SVashi/491-Project/KiCad/batteryless_gaming_device/batteryless_gaming_device.kicad_pcb

## KiCad design KiCad/batteryless_gaming_device/batteryless_gaming_device.kicad_pcb (2021-11-18)

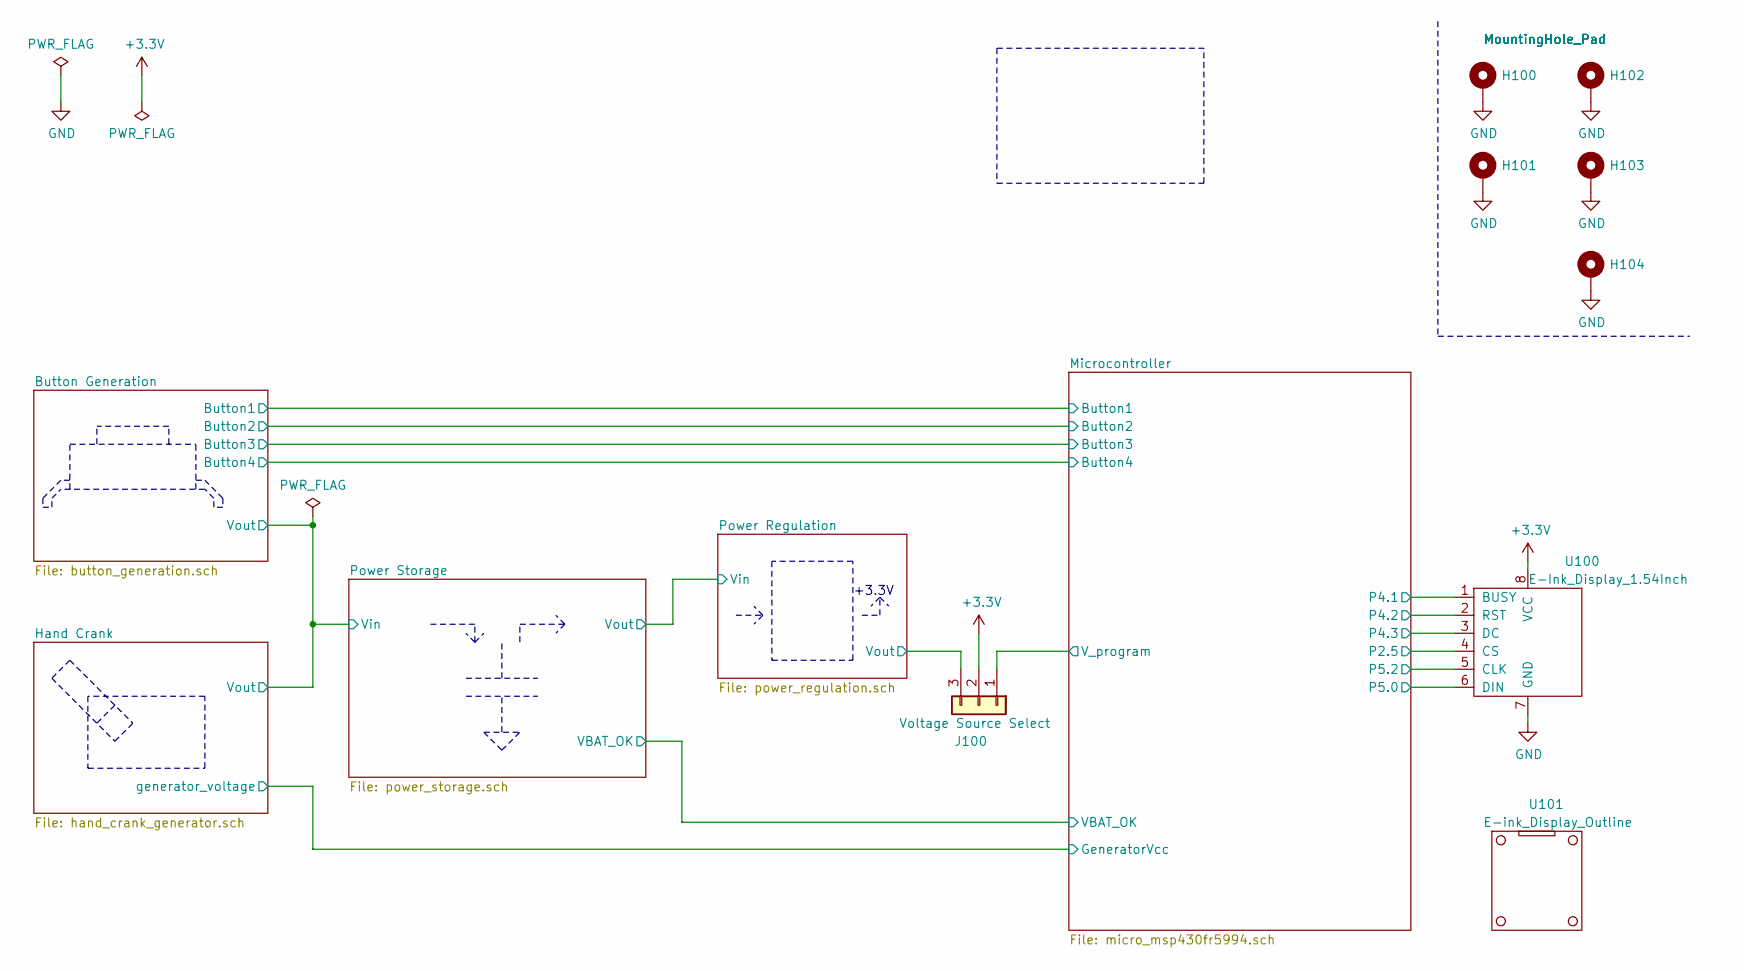
[picture p1: schematic batteryless_gaming_device.sch, Battery Free Gaming Device]

Parts:
H100, H101, H102, H103, H104: MountingHole_Pad; MountingHole_3.2mm_M3_DIN965_Pad
J100: Voltage Source Select; PinHeader_1x03_P2.54mm_Vertical
U100: E-Ink_Display_1.54Inch; PinHeader_1x08_P2.54mm_Horizontal
U101: E-ink_Display_Outline; E-Ink_Display_1.54Inch

Connections:
+3V3: J100.2, U100.8 (VCC); also elsewhere on the board
/Microcontroller/P2.5: U100.4 (CS); also elsewhere on the board
/Microcontroller/P4.1: U100.1 (BUSY); also elsewhere on the board
/Microcontroller/P4.2: U100.2 (RST); also elsewhere on the board
/Microcontroller/P4.3: U100.3 (DC); also elsewhere on the board
/Microcontroller/P5.0: U100.6 (DIN); also elsewhere on the board
/Microcontroller/P5.2: U100.5 (CLK); also elsewhere on the board
/Microcontroller/V_program: J100.1; also elsewhere on the board
/Power Regulation/Vout: J100.3; also elsewhere on the board
GND: H100.1, H101.1, H102.1, H103.1, H104.1, U100.7 (GND); also elsewhere on the board

Notes on the sheet:
+3.3V

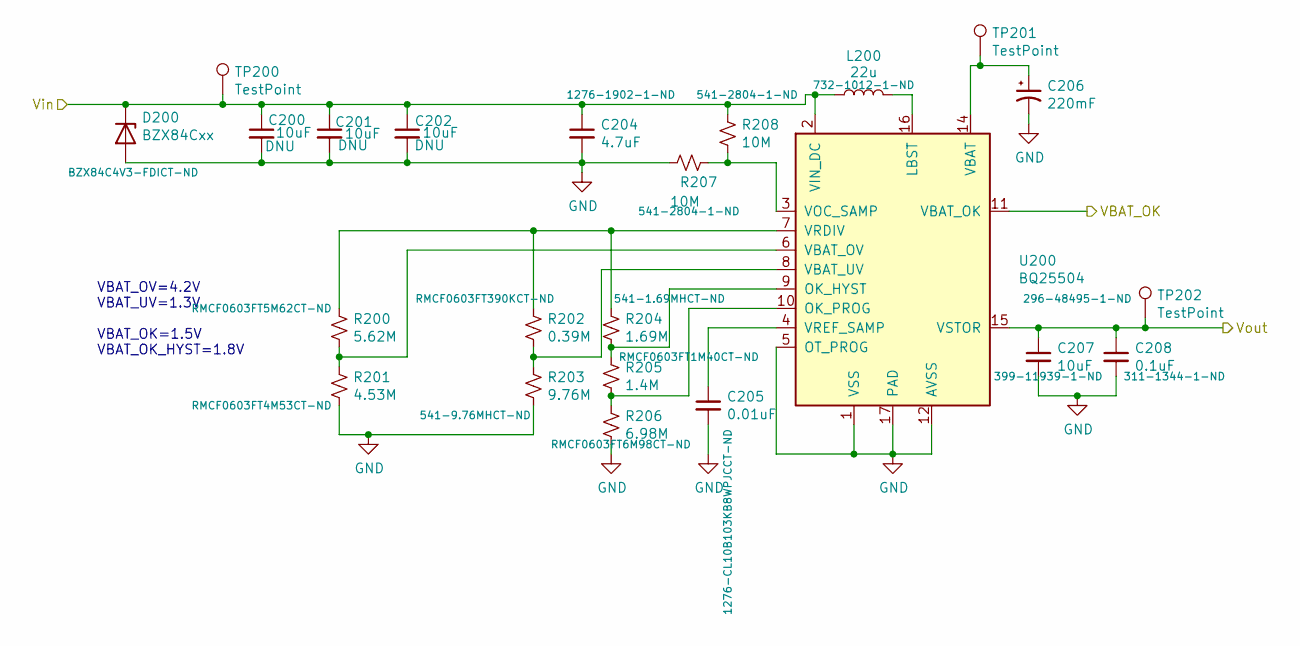
[picture p2: schematic power_storage.sch]

Parts:
C200, C201, C202: 10uF; C_0805_2012Metric_Pad1.18x1.45mm_HandSolder; Digikey PN DNU
C204: 4.7uF; C_0603_1608Metric_Pad1.08x0.95mm_HandSolder; Digikey PN 1276-1902-1-ND
C205: 0.01uF; C_0603_1608Metric_Pad1.08x0.95mm_HandSolder; Digikey PN 1276-CL10B103KB8WPJCCT-ND
C206: 220mF; CP_Radial_D14.0mm_P5.00mm
C207: 10uF; C_0805_2012Metric_Pad1.18x1.45mm_HandSolder; Digikey PN 399-11939-1-ND
C208: 0.1uF; C_0603_1608Metric_Pad1.08x0.95mm_HandSolder; Digikey PN 311-1344-1-ND
D200: BZX84Cxx; D_SOT-23_ANK_HandSoldering; Digikey PN BZX84C4V3-FDICT-ND
L200: 22u; L_Wuerth-3816_6.3x6.3mm; Digikey PN 732-1012-1-ND
R200: 5.62M; R_0603_1608Metric_Pad0.98x0.95mm_HandSolder; Digikey PN RMCF0603FT5M62CT-ND
R201: 4.53M; R_0603_1608Metric_Pad0.98x0.95mm_HandSolder; Digikey PN RMCF0603FT4M53CT-ND
R202: 0.39M; R_0603_1608Metric_Pad0.98x0.95mm_HandSolder; Digikey PN RMCF0603FT390KCT-ND
R203: 9.76M; R_0603_1608Metric_Pad0.98x0.95mm_HandSolder; Digikey PN 541-9.76MHCT-ND
R204: 1.69M; R_0603_1608Metric_Pad0.98x0.95mm_HandSolder; Digikey PN 541-1.69MHCT-ND
R205: 1.4M; R_0603_1608Metric_Pad0.98x0.95mm_HandSolder; Digikey PN RMCF0603FT1M40CT-ND
R206: 6.98M; R_0603_1608Metric_Pad0.98x0.95mm_HandSolder; Digikey PN RMCF0603FT6M98CT-ND
R207, R208: 10M; R_0603_1608Metric_Pad0.98x0.95mm_HandSolder; Digikey PN 541-2804-1-ND
TP200, TP201, TP202: TestPoint; TestPoint_Pad_D2.0mm
U200: BQ25504; VQFN-16-1EP_3x3mm_P0.5mm_EP1.8x1.8mm; Digikey PN 296-48495-1-ND

Connections:
/Microcontroller/VBAT_OK: U200.11 (VBAT_OK); also elsewhere on the board
/Power Regulation/Vin: C207.1, C208.1, TP202.1, U200.15 (VSTOR); also elsewhere on the board
/Power Storage/Vin: C200.1, C201.1, C202.1, C204.1, D200.1 (K), L200.1, R208.1, TP200.1, U200.2 (VIN_DC); also elsewhere on the board
GND: C200.2, C201.2, C202.2, C204.2, C205.2, C206.2, C207.2, C208.2, D200.2 (A), R201.2, R203.2, R206.2, R207.2, U200.1 (VSS), U200.5 (OT_PROG), U200.12 (AVSS), U200.13 (VSS), U200.17 (PAD); also elsewhere on the board
unnamed: C205.1, U200.4 (VREF_SAMP)
unnamed: C206.1, TP201.1, U200.14 (VBAT)
unnamed: L200.2, U200.16 (LBST)
unnamed: R200.1, R202.1, R204.1, U200.7 (VRDIV)
unnamed: R200.2, R201.1, U200.6 (VBAT_OV)
unnamed: R202.2, R203.1, U200.8 (VBAT_UV)
unnamed: R204.2, R205.1, U200.9 (OK_HYST)
unnamed: R205.2, R206.1, U200.10 (OK_PROG)
unnamed: R207.1, R208.2, U200.3 (VOC_SAMP)

Notes on the sheet:
VBAT_OV=4.2V VBAT_UV=1.3V VBAT_OK=1.5V VBAT_OK_HYST=1.8V

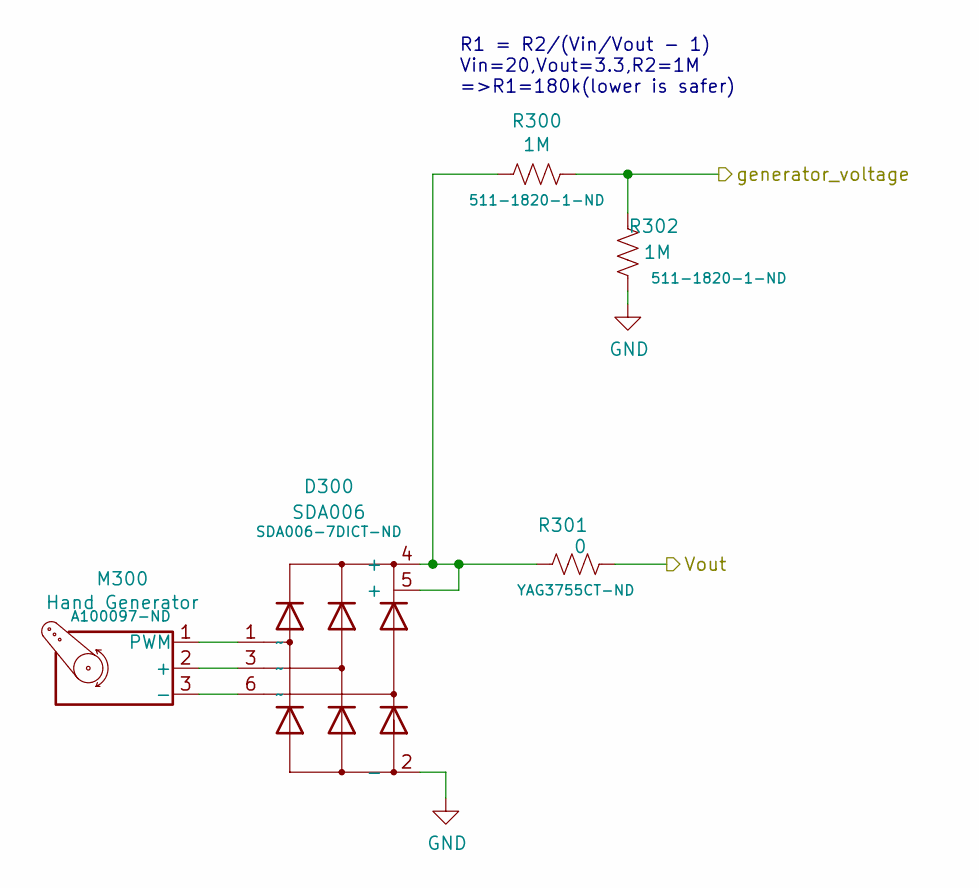
[picture p3: schematic hand_crank_generator.sch]

Parts:
D300: SDA006; SOT-363_SC-70-6_Handsoldering; Digikey PN SDA006-7DICT-ND
M300: Hand Generator; PinHeader_1x03_P2.00mm_Vertical; Digikey PN A100097-ND
R300, R302: 1M; R_0603_1608Metric_Pad0.98x0.95mm_HandSolder; Digikey PN 511-1820-1-ND
R301: 0; R_0805_2012Metric_Pad1.20x1.40mm_HandSolder; Digikey PN YAG3755CT-ND

Connections:
/Microcontroller/GeneratorVcc: R300.1, R302.2; also elsewhere on the board
/Power Storage/Vin: R301.2; also elsewhere on the board
GND: D300.2 (-), R302.1; also elsewhere on the board
unnamed: D300.1 (~~), M300.1 (PWM)
unnamed: D300.3 (~~), M300.2 (+)
unnamed: D300.4 (+), D300.5 (+), R300.2, R301.1
unnamed: D300.6 (~~), M300.3 (-)

Notes on the sheet:
R1 = R2/(Vin/Vout - 1) Vin=20,Vout=3.3,R2=1M =>R1=180k(lower is safer)

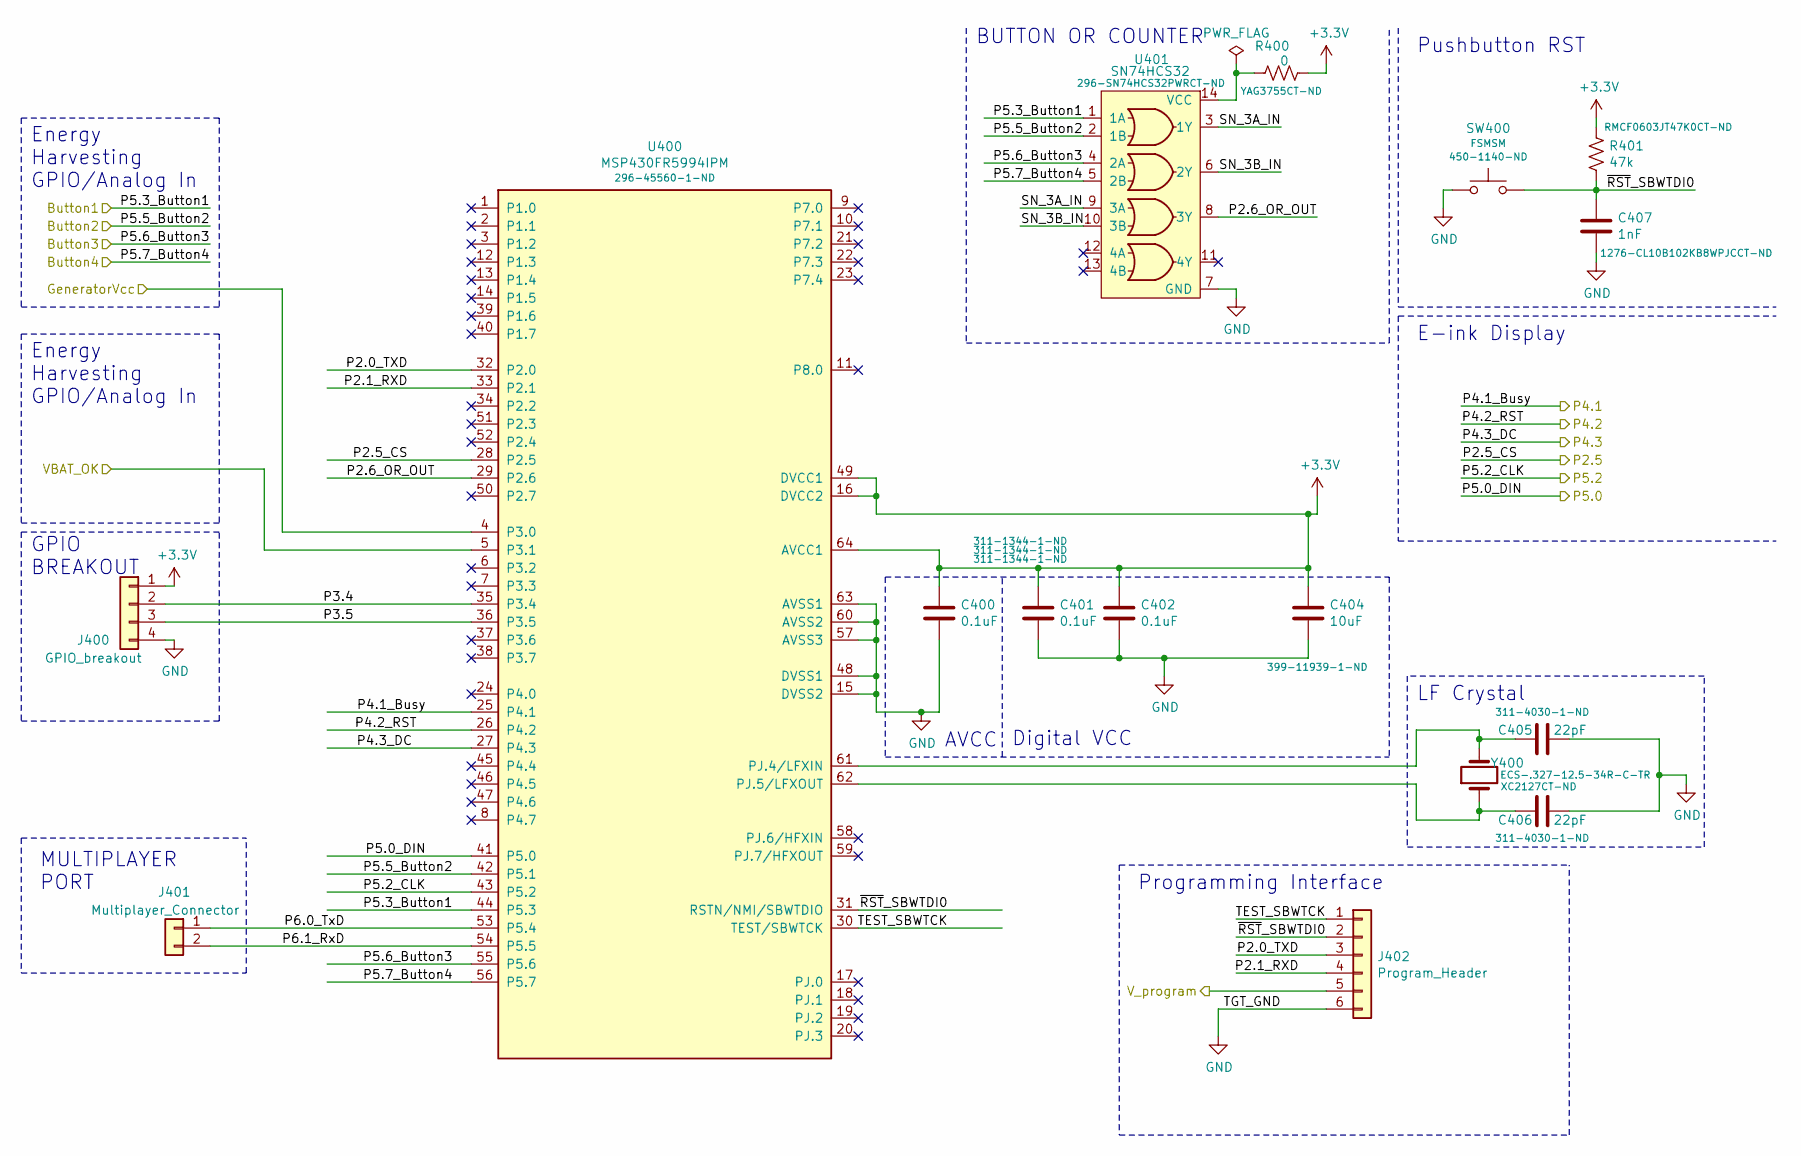
[picture p4: schematic micro_msp430fr5994.sch]

Parts:
C400, C401, C402: 0.1uF; C_0603_1608Metric_Pad1.08x0.95mm_HandSolder; Digikey PN 311-1344-1-ND
C404: 10uF; C_0805_2012Metric_Pad1.18x1.45mm_HandSolder; Digikey PN 399-11939-1-ND
C405, C406: 22pF; C_0603_1608Metric_Pad1.08x0.95mm_HandSolder; Digikey PN 311-4030-1-ND
C407: 1nF; C_0603_1608Metric_Pad1.08x0.95mm_HandSolder; Digikey PN 1276-CL10B102KB8WPJCCT-ND
J400: GPIO_breakout; PinHeader_1x04_P2.54mm_Vertical
J401: Multiplayer_Connector; PinHeader_1x02_P2.54mm_Horizontal
J402: Program_Header; PinHeader_1x06_P2.54mm_Vertical
R400: 0; R_0805_2012Metric_Pad1.20x1.40mm_HandSolder; Digikey PN YAG3755CT-ND
R401: 47k; R_0603_1608Metric_Pad0.98x0.95mm_HandSolder; Digikey PN RMCF0603JT47K0CT-ND
SW400: FSMSM; SW_SPST_FSMSM; Digikey PN 450-1140-ND
U400: MSP430FR5994IPM; LQFP-64_10x10mm_P0.5mm; Digikey PN 296-45560-1-ND
U401: SN74HCS32; TSSOP-14_4.4x5mm_P0.65mm; Digikey PN 296-SN74HCS32PWRCT-ND
Y400: ECS-.327-12.5-34R-C-TR; Crystal_SMD_3215-2Pin_3.2x1.5mm; Digikey PN XC2127CT-ND

Connections:
+3V3: C400.1, C401.1, C402.1, C404.1, J400.1, R400.2, R401.1, U400.16 (DVCC2), U400.49 (DVCC1), U400.64 (AVCC1); also elsewhere on the board
/Button Generation/Button1: U400.44 (P5.3), U401.1 (1A); also elsewhere on the board
/Button Generation/Button2: U400.42 (P5.1), U401.2 (1B); also elsewhere on the board
/Button Generation/Button3: U400.55 (P5.6), U401.4 (2A); also elsewhere on the board
/Button Generation/Button4: U400.56 (P5.7), U401.5 (2B); also elsewhere on the board
/Microcontroller/GeneratorVcc: U400.4 (P3.0); also elsewhere on the board
/Microcontroller/P2.0_TXD: J402.3, U400.32 (P2.0)
/Microcontroller/P2.1_RXD: J402.4, U400.33 (P2.1)
/Microcontroller/P2.5: U400.28 (P2.5); also elsewhere on the board
/Microcontroller/P2.6_OR_OUT: U400.29 (P2.6), U401.8 (3Y)
/Microcontroller/P3.4: J400.2, U400.35 (P3.4)
/Microcontroller/P3.5: J400.3, U400.36 (P3.5)
/Microcontroller/P4.1: U400.25 (P4.1); also elsewhere on the board
/Microcontroller/P4.2: U400.26 (P4.2); also elsewhere on the board
/Microcontroller/P4.3: U400.27 (P4.3); also elsewhere on the board
/Microcontroller/P5.0: U400.41 (P5.0); also elsewhere on the board
/Microcontroller/P5.2: U400.43 (P5.2); also elsewhere on the board
/Microcontroller/P6.0_TxD: J401.1, U400.53 (P5.4)
/Microcontroller/P6.1_RxD: J401.2, U400.54 (P5.5)
/Microcontroller/SN_3A_IN: U401.3 (1Y), U401.9 (3A)
/Microcontroller/SN_3B_IN: U401.6 (2Y), U401.10 (3B)
/Microcontroller/TEST_SBWTCK: J402.1, U400.30 (TEST/SBWTCK)
/Microcontroller/VBAT_OK: U400.5 (P3.1); also elsewhere on the board
/Microcontroller/V_program: J402.5; also elsewhere on the board
/Microcontroller/~RST~_SBWTDI0: C407.1, J402.2, R401.2, SW400.2, U400.31 (RSTN/NMI/SBWTDIO)
GND: C400.2, C401.2, C402.2, C404.2, C405.2, C406.2, C407.2, J400.4, J402.6, SW400.1, U400.15 (DVSS2), U400.48 (DVSS1), U400.57 (AVSS3), U400.60 (AVSS2), U400.63 (AVSS1), U401.7 (GND); also elsewhere on the board
unnamed: C405.1, U400.61 (PJ.4/LFXIN), Y400.2
unnamed: C406.1, U400.62 (PJ.5/LFXOUT), Y400.1
unnamed: R400.1, U401.14 (VCC)

Notes on the sheet:
Digital VCC
AVCC
LF Crystal
Pushbutton RST
Programming Interface
Energy Harvesting GPIO/Analog In
E-ink Display
BUTTON OR COUNTER
MULTIPLAYER PORT
GPIO BREAKOUT

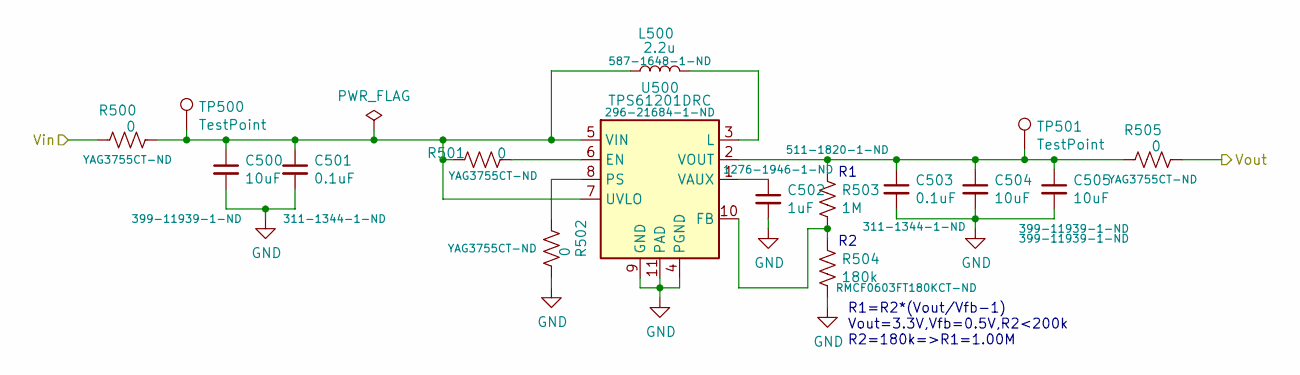
[picture p5: schematic power_regulation.sch]

Parts:
C500, C504, C505: 10uF; C_0805_2012Metric_Pad1.18x1.45mm_HandSolder; Digikey PN 399-11939-1-ND
C501, C503: 0.1uF; C_0603_1608Metric_Pad1.08x0.95mm_HandSolder; Digikey PN 311-1344-1-ND
C502: 1uF; C_0603_1608Metric_Pad1.08x0.95mm_HandSolder; Digikey PN 1276-1946-1-ND
L500: 2.2u; L_Taiyo-Yuden_NR-30xx_HandSoldering; Digikey PN 587-1648-1-ND
R500, R501, R502, R505: 0; R_0805_2012Metric_Pad1.20x1.40mm_HandSolder; Digikey PN YAG3755CT-ND
R503: 1M; R_0603_1608Metric_Pad0.98x0.95mm_HandSolder; Digikey PN 511-1820-1-ND
R504: 180k; R_0603_1608Metric_Pad0.98x0.95mm_HandSolder; Digikey PN RMCF0603FT180KCT-ND
TP500, TP501: TestPoint; TestPoint_Pad_D2.0mm
U500: TPS61201DRC; Texas_S-PVSON-N10_ThermalVias; Digikey PN 296-21684-1-ND

Connections:
/Power Regulation/Vin: R500.1; also elsewhere on the board
/Power Regulation/Vout: R505.2; also elsewhere on the board
GND: C500.2, C501.2, C502.2, C503.2, C504.2, C505.2, R502.2, R504.2, U500.4 (PGND), U500.9 (GND), U500.11 (PAD); also elsewhere on the board
unnamed: C500.1, C501.1, L500.1, R500.2, R501.1, TP500.1, U500.5 (VIN), U500.7 (UVLO)
unnamed: C502.1, U500.1 (VAUX)
unnamed: C503.1, C504.1, C505.1, R503.1, R505.1, TP501.1, U500.2 (VOUT)
unnamed: L500.2, U500.3 (L)
unnamed: R501.2, U500.6 (EN)
unnamed: R502.1, U500.8 (PS)
unnamed: R503.2, R504.1, U500.10 (FB)

Notes on the sheet:
R1=R2*(Vout/Vfb-1) Vout=3.3V,Vfb=0.5V,R2<200k R2=180k=>R1=1.00M

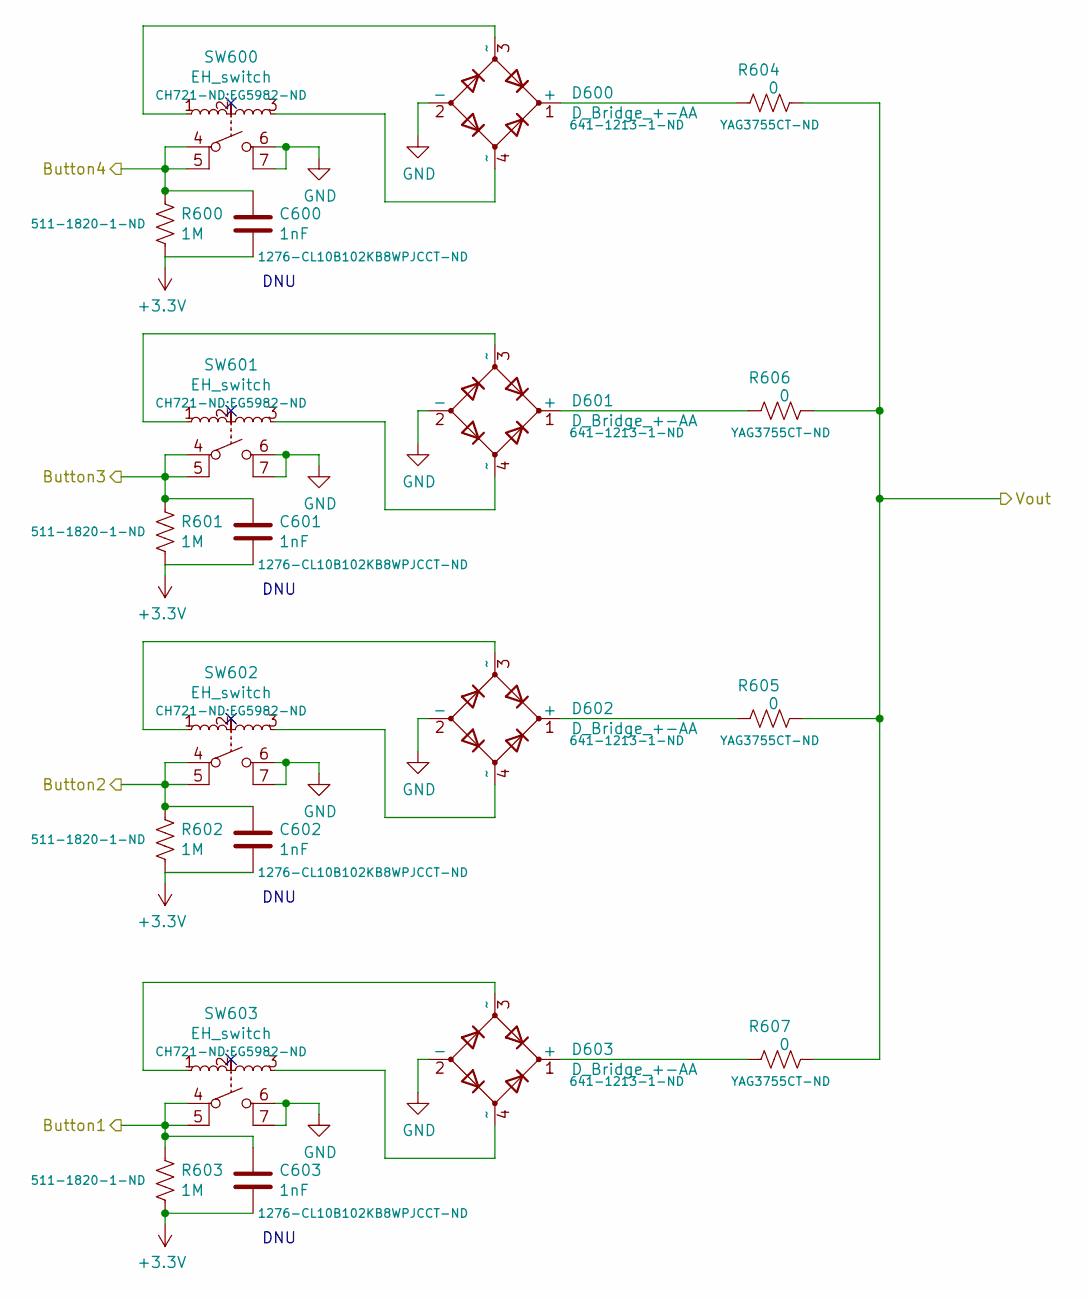
[picture p6: schematic button_generation.sch]

Parts:
C600, C601, C602, C603: 1nF; C_0603_1608Metric_Pad1.08x0.95mm_HandSolder; Digikey PN 1276-CL10B102KB8WPJCCT-ND
D600, D601, D602, D603: D_Bridge_+-AA; TO-269AA; Digikey PN 641-1213-1-ND
R600, R601, R602, R603: 1M; R_0603_1608Metric_Pad0.98x0.95mm_HandSolder; Digikey PN 511-1820-1-ND
R604, R605, R606, R607: 0; R_0805_2012Metric_Pad1.20x1.40mm_HandSolder; Digikey PN YAG3755CT-ND
SW600, SW601, SW602, SW603: EH_switch; EH_switch_v2; Digikey PN CH721-ND;EG5982-ND

Connections:
+3V3: C600.2, C601.2, C602.2, C603.2, R600.2, R601.2, R602.2, R603.2; also elsewhere on the board
/Button Generation/Button1: C603.1, R603.1, SW603.4 (1), SW603.5 (2); also elsewhere on the board
/Button Generation/Button2: C602.1, R602.1, SW602.4 (1), SW602.5 (2); also elsewhere on the board
/Button Generation/Button3: C601.1, R601.1, SW601.4 (1), SW601.5 (2); also elsewhere on the board
/Button Generation/Button4: C600.1, R600.1, SW600.4 (1), SW600.5 (2); also elsewhere on the board
/Power Storage/Vin: R604.2, R605.2, R606.2, R607.2; also elsewhere on the board
GND: D600.2 (-), D601.2 (-), D602.2 (-), D603.2 (-), SW600.6 (A), SW600.7 (K), SW601.6 (A), SW601.7 (K), SW602.6 (A), SW602.7 (K), SW603.6 (A), SW603.7 (K); also elsewhere on the board
unnamed: D600.1 (+), R604.1
unnamed: D600.3 (~~), SW600.1
unnamed: D600.4 (~~), SW600.3
unnamed: D601.1 (+), R606.1
unnamed: D601.3 (~~), SW601.1
unnamed: D601.4 (~~), SW601.3
unnamed: D602.1 (+), R605.1
unnamed: D602.3 (~~), SW602.1
unnamed: D602.4 (~~), SW602.3
unnamed: D603.1 (+), R607.1
unnamed: D603.3 (~~), SW603.1
unnamed: D603.4 (~~), SW603.3

Notes on the sheet:
DNU

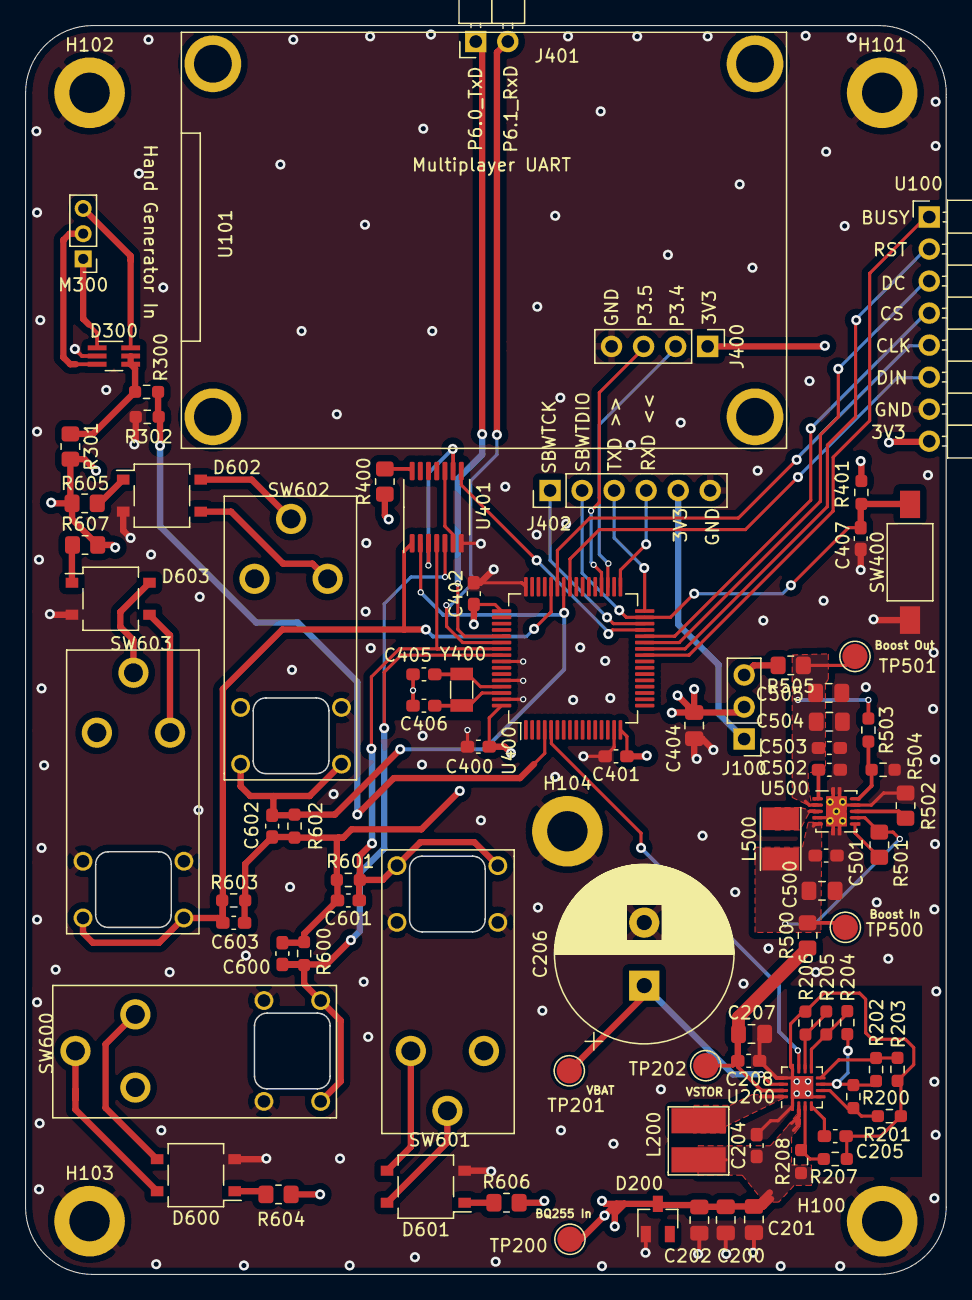
[picture p7: board batteryless_gaming_device.kicad_pcb from above]

Board: 4 copper layers, 73.0 x 99.1 mm, 88 parts (0 on the bottom side), 64 nets.
