SVashi/491-Project/KiCad/bq25504_breakout_module/bq25504_breakout_module.kicad_pcb

## KiCad design KiCad/bq25504_breakout_module/bq25504_breakout_module.kicad_pcb (2021-11-04)

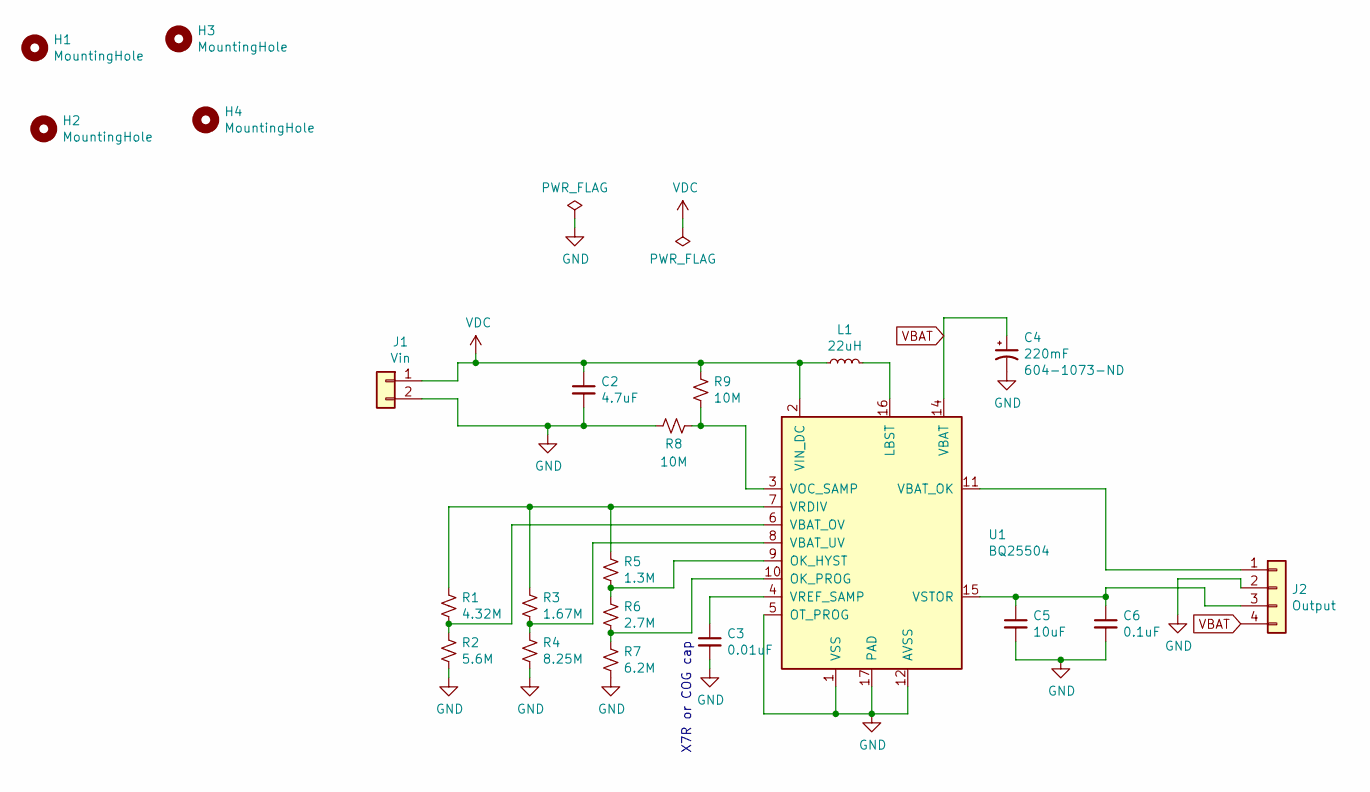
[picture p8: schematic bq25504_breakout_module.sch]

Parts:
C2: 4.7uF; C_0603_1608Metric_Pad1.08x0.95mm_HandSolder
C3: 0.01uF; C_0603_1608Metric_Pad1.08x0.95mm_HandSolder
C4: 220mF; CP_Radial_D14.0mm_P5.00mm; Digikey PN 604-1073-ND
C5: 10uF; C_0805_2012Metric_Pad1.18x1.45mm_HandSolder
C6: 0.1uF; C_0603_1608Metric_Pad1.08x0.95mm_HandSolder
H1, H2, H3, H4: MountingHole; MountingHole_3.2mm_M3
J1: Vin; PinHeader_1x02_P2.54mm_Vertical
J2: Output; PinHeader_1x04_P2.54mm_Vertical
L1: 22uH; L_Wuerth-3816_6.3x6.3mm
R1: 4.32M; R_0603_1608Metric_Pad0.98x0.95mm_HandSolder
R2: 5.6M; R_0603_1608Metric_Pad0.98x0.95mm_HandSolder
R3: 1.67M; R_0603_1608Metric_Pad0.98x0.95mm_HandSolder
R4: 8.25M; R_0603_1608Metric_Pad0.98x0.95mm_HandSolder
R5: 1.3M; R_0603_1608Metric_Pad0.98x0.95mm_HandSolder
R6: 2.7M; R_0603_1608Metric_Pad0.98x0.95mm_HandSolder
R7: 6.2M; R_0603_1608Metric_Pad0.98x0.95mm_HandSolder
R8, R9: 10M; R_0603_1608Metric_Pad0.98x0.95mm_HandSolder
U1: BQ25504; QFN-16-1EP_3x3mm_P0.5mm_EP1.7x1.7mm_HandSolder

Connections:
GND: C2.2, C3.2, C4.2, C5.2, C6.2, J1.2, J2.2, R2.2, R4.2, R7.2, R8.1, U1.1 (VSS), U1.5 (OT_PROG), U1.12 (AVSS), U1.13 (VSS), U1.17 (PAD)
unnamed: C3.1, U1.4 (VREF_SAMP)
unnamed: C5.1, C6.1, J2.3, U1.15 (VSTOR)
unnamed: J2.1, U1.11 (VBAT_OK)
unnamed: L1.2, U1.16 (LBST)
unnamed: R1.1, R3.1, R5.1, U1.7 (VRDIV)
unnamed: R1.2, R2.1, U1.6 (VBAT_OV)
unnamed: R3.2, R4.1, U1.8 (VBAT_UV)
unnamed: R5.2, R6.1, U1.9 (OK_HYST)
unnamed: R6.2, R7.1, U1.10 (OK_PROG)
unnamed: R8.2, R9.2, U1.3 (VOC_SAMP)
VBAT: C4.1, J2.4, U1.14 (VBAT)
VDC: C2.1, J1.1, L1.1, R9.1, U1.2 (VIN_DC)

Notes on the sheet:
X7R or COG cap

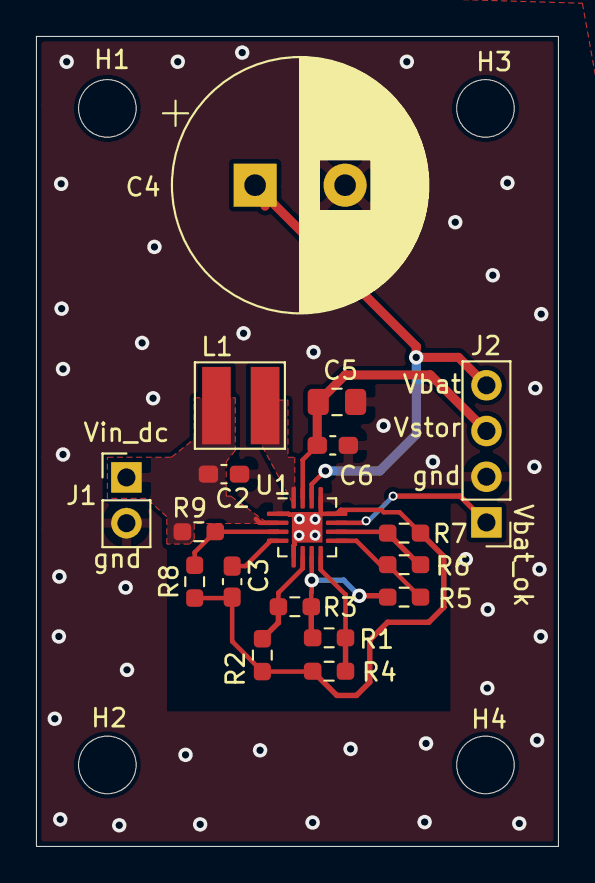
[picture p9: board bq25504_breakout_module.kicad_pcb from above]

Board: 2 copper layers, 29.0 x 45.0 mm, 22 parts (0 on the bottom side), 13 nets.
