SVashi/491-Project/KiCad/BoostRegulatorBreakoutPCB/BoostRegulatorBreakoutPCB/BoostRegulatorBreakoutPCB.kicad_pcb

## KiCad design KiCad/BoostRegulatorBreakoutPCB/BoostRegulatorBreakoutPCB/BoostRegulatorBreakoutPCB.kicad_pcb (2021-09-09)

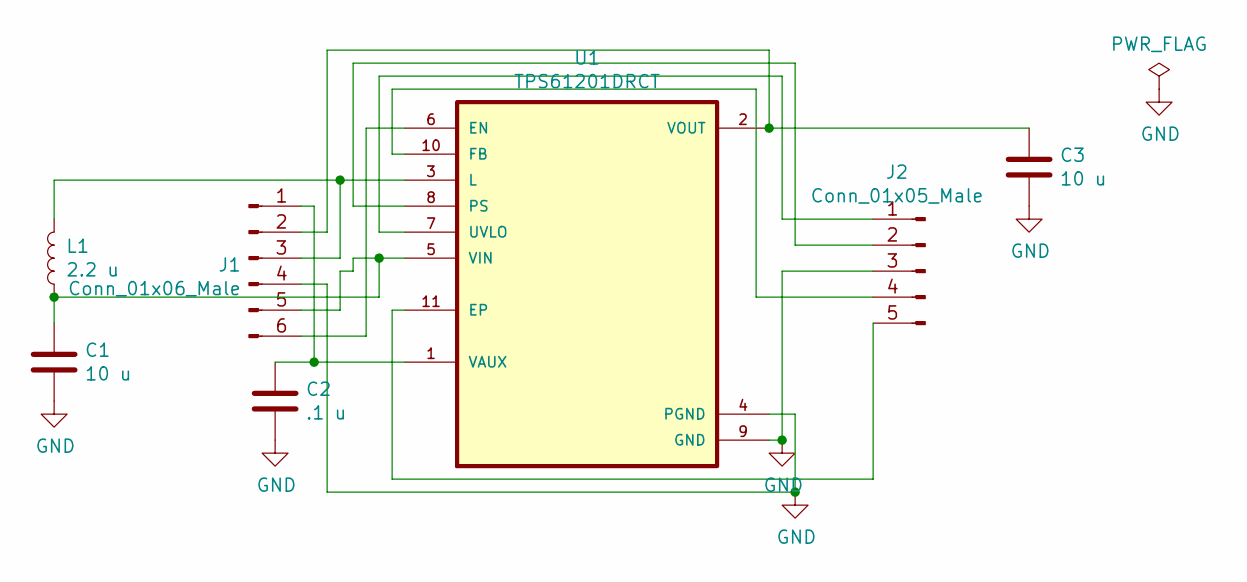
[picture p10: schematic BoostRegulatorBreakoutPCB.sch]

Parts:
C1, C3: 10 u; CP_Radial_D5.0mm_P2.50mm
C2: .1 u; CP_Radial_D5.0mm_P2.50mm
J1: Conn_01x06_Male; PinSocket_1x06_P2.54mm_Vertical
J2: Conn_01x05_Male; PinSocket_1x05_P2.54mm_Vertical
L1: 2.2 u; L_Axial_L5.0mm_D3.6mm_P10.00mm_Horizontal_Murata_BL01RN1A2A2
U1: TPS61201DRCT; DFN-10-1EP_3x3mm_P0.5mm_EP1.7x2.5mm_HandSolder

Connections:
GND: C1.2, C2.2, C3.2, J1.4, J2.3, U1.4 (PGND), U1.9 (GND)
unnamed: C1.1, J1.5, L1.1, U1.5 (VIN)
unnamed: C2.1, J1.1, U1.1 (VAUX)
unnamed: C3.1, J1.2, U1.2 (VOUT)
unnamed: J1.3, L1.2, U1.3 (L)
unnamed: J1.6, U1.6 (EN)
unnamed: J2.1, U1.7 (UVLO)
unnamed: J2.2, U1.8 (PS)
unnamed: J2.4, U1.10 (FB)
unnamed: J2.5, U1.11 (EP)

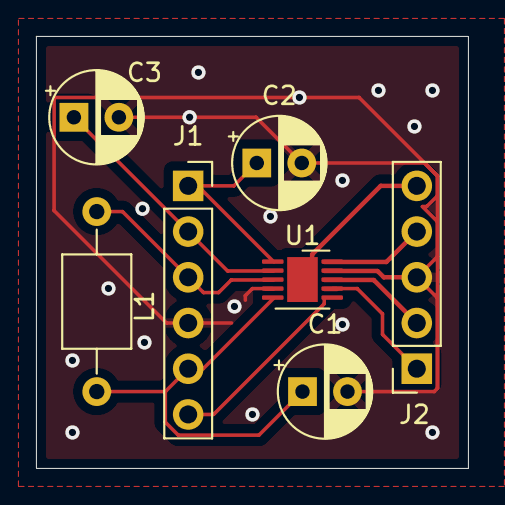
[picture p11: board BoostRegulatorBreakoutPCB.kicad_pcb from above]

Board: 2 copper layers, 24.0 x 24.0 mm, 7 parts (0 on the bottom side), 10 nets.
