SVashi/491-Project/(commit log)

2021-09-05 created kicad folder
    [batteryless_gaming_device.kicad_pcb, batteryless_gaming_device.sch, button_detect.sch]
2021-09-05 test update
    [batteryless_gaming_device.sch]
2021-09-05 moved part to test hub
    [batteryless_gaming_device.sch]
2021-09-07 created bq25504 module/breakout board
    [bq25504_breakout_module-B_Cu.gbr, bq25504_breakout_module-B_Mask.gbr, bq25504_breakout_module-B_Paste.gbr, bq25504_breakout_module-B_SilkS.gbr, bq25504_breakout_module-Edge_Cuts.gbr, bq25504_breakout_module-F_Cu.gbr, bq25504_breakout_module-F_Mask.gbr, bq25504_breakout_module-F_Paste.gbr]
2021-09-08 updated bq25504
    [bq25504_breakout_module-B_Cu.gbr, bq25504_breakout_module-B_Mask.gbr, bq25504_breakout_module-B_Paste.gbr, bq25504_breakout_module-B_SilkS.gbr, bq25504_breakout_module-Edge_Cuts.gbr, bq25504_breakout_module-F_Cu.gbr, bq25504_breakout_module-F_Mask.gbr, bq25504_breakout_module-F_Paste.gbr]
2021-09-09 confirmed jakes breakout board layout
    [BoostRegulatorBreakoutPCB-B_Cu.gbr, BoostRegulatorBreakoutPCB-B_Mask.gbr, BoostRegulatorBreakoutPCB-B_Paste.gbr, BoostRegulatorBreakoutPCB-B_SilkS.gbr, BoostRegulatorBreakoutPCB-Edge_Cuts.gbr, BoostRegulatorBreakoutPCB-F_Cu.gbr, BoostRegulatorBreakoutPCB-F_Mask.gbr, BoostRegulatorBreakoutPCB-F_Paste.gbr]
2021-09-30 updated some stuff
    [bq25504_breakout_module.csv]
2021-11-14 updated some stuff in main schematic
    [batteryless_gaming_device.sch, button_generation.sch, hand_crank_generator.sch, power_storage.sch]
2021-11-14 keep updating schematic
    [batteryless_gaming_device.sch, button_generation.sch, hand_crank_generator.sch, micro_msp430fr5994.sch, power_storage.sch]
2021-11-14 keep on keeping on
    [batteryless_gaming_device.sch]
2021-11-15 updated schematic
    [batteryless_gaming_device.sch, button_generation.sch, hand_crank_generator.sch, micro_msp430fr5994.sch, power_regulation.sch, power_storage.sch]
2021-11-17 just kinda out here guys ya know what im saying
    [batteryless_gaming_device.kicad_pcb, batteryless_gaming_device.sch, button_generation.sch, hand_crank_generator.sch, micro_msp430fr5994.sch, power_regulation.sch, power_storage.sch]
2021-11-18 oh ya
    [batteryless_gaming_device.kicad_pcb, batteryless_gaming_device.sch, batteryless_gaming_device_bom_Rev 0_(Normal).csv, batteryless_handheld_game_final_bom.csv, button_generation.sch, hand_crank_generator.sch, micro_msp430fr5994.sch, power_regulation.sch]
